freecores/utosnet/hardware/readme.txt

The hardware designs have been created with Altium Designer.

A free viewer exists for the files, it can be downloaded here:
http://altium.com/community/downloads/downloads_home.cfm
