freecores/utosnet/(list of files, drawings)

Other design files:
hardware/Spartan3_50AN_addon/50AN Digi.PcbDoc
hardware/Spartan3_50AN_addon/50AN_DIGI.PrjPcb
hardware/Spartan3_50AN_addon/50AN_DIGI.SchDoc
hardware/Spartan3_50AN_main/IO connections.SchDoc
hardware/Spartan3_50AN_main/KISS_Spartan3.PrjPcb
hardware/Spartan3_50AN_main/PCB.PcbDoc
hardware/Spartan3_50AN_main/Power.SchDoc
